reihakuro/DoAn2/schematic/power-source-board.png

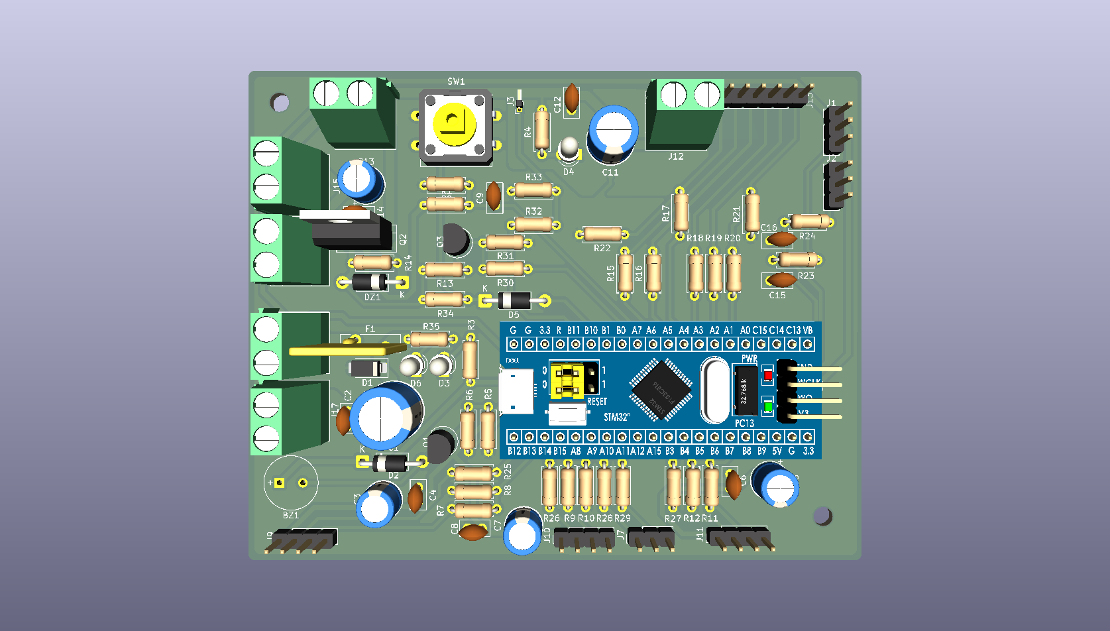
schematic/power-source-board.png
