reihakuro/DoAn2/Xe tự hành vận chuyển linh kiện.docx

Chống Định Khang - 23161277

Phạm Trung Kiên - 23161283

XE TỰ HÀNH VẬN CHUYỂN LINH KIỆN

1. Đặt vấn đề

Trong các môi trường làm việc kỹ thuật như phòng thí nghiệm điện tử, xưởng lắp ráp thiết bị và văn phòng nghiên cứu, nhu cầu luân chuyển các khay linh kiện, bo mạch mẫu, tài liệu và dụng cụ đo đạc giữa các bàn làm việc diễn ra liên tục. Việc di chuyển thủ công các vật phẩm nhỏ này làm gián đoạn thời gian tập trung chuyên môn của kỹ sư, đồng thời giảm hiệu suất chung của dây chuyền thử nghiệm.

Đề tài “Xe tự hành vận chuyển linh kiện” được triển khai nhằm xây dựng một mô hình xe tự hành cỡ nhỏ phục vụ giao nhận vật tư kỹ thuật tự động. Hệ thống không phụ thuộc vào các đường dẫn cố định bằng cách sử dụng thị giác máy tính nhận diện mốc tại các trạm đích kết hợp camera cố định với xoay thân xe, cụm cảm biến khoảng cách đa hướng và cảm biến đo tốc độ bánh xe. Toàn bộ hệ thống vận hành theo kiến trúc điều khiển phân tầng giữa máy tính nhúng và vi điều khiển thời gian thực để giám sát và điều khiển từ xa thông qua Web.

2. Mục tiêu đề tài

Mục tiêu chính của đề tài là thiết kế và chế tạo mô hình xe tự hành vận chuyển nội bộ hoạt động ổn định, đáp ứng yêu cầu an toàn không phụ thuộc vào vạch kẻ đường cố định. Các mục tiêu cụ thể bao gồm:

- Tự hành điều hướng theo mốc: Nhận diện mã hình học dán tại các trạm làm việc thông qua camera phía trước, tính toán sai số góc lệch để tự động bám quỹ đạo và di chuyển chính xác đến trạm đích trong không gian mở.
- Quét tìm trạm bằng xoay thân xe: Camera được gắn cố định cứng vững trên thân xe; hệ thống điều khiển thân xe xoay từng góc để tìm kiếm trạm.
- Kiểm soát an toàn và phản xạ: Sử dụng cụm cảm biến khoảng cách đa hướng phía trước quét theo phân chia thời gian để dừng khẩn cấp khi gặp người đi cắt ngang hoặc tránh chướng ngại vật tĩnh, kết hợp nút dừng khẩn cấp ngắt trực tiếp nguồn động cơ.
- Tối ưu hóa kiến trúc điều khiển phân tầng: Xử lý ảnh và vận hành máy chủ điều phối web cho máy tính nhúng, đo đạc cảm biến thời gian thực điều khiển động cơ và ngắt an toàn cho vi điều khiển.
- Thử nghiệm hoạt động thực tế trong môi trường test: Kiểm tra khả năng nhận diện mốc, tự động di chuyển đến đúng vị trí trạm chỉ định và phản xạ dừng an toàn khi gặp chướng ngại vật.

3. Thiết kế hệ thống

3.1. Yêu cầu người dùng

Hệ thống được thiết kế hướng tới hỗ trợ công tác luân chuyển vật tư trong phòng thí nghiệm, đáp ứng các yêu cầu thực tế sau:

- Tiếp nhận lệnh điều phối từ xa: Người vận hành tại các bàn đo đạc có thể sử dụng điện thoại hay máy tính truy cập trang web điều phối để phát lệnh yêu cầu xe vận chuyển linh kiện giữa các trạm mà không cần thao tác trực tiếp trên thân xe.
- Tự động tìm kiếm và dừng tại trạm chính xác: Sau khi nhận lệnh, xe tự kích hoạt cụm camera quét tìm trạm yêu cầu, bám theo mục tiêu và dừng đỗ ổn định trước bàn làm việc để người dùng giao nhận khay linh kiện.
- Đảm bảo an toàn tuyệt đối khi di chuyển: Xe liên tục kiểm tra chướng ngại vật phía trước, tự động dừng và phát còi cảnh báo khi có người qua lại, trang bị nút dừng khẩn cấp trên nóc xe để ngắt nguồn động cơ ngay lập tức khi cần thiết.
- Giám sát hình ảnh: Người dùng có thể theo dõi góc nhìn phía trước của xe qua luồng video trực tiếp trên giao diện web, quan sát trạng thái nhiệm vụ và số đo khoảng cách an toàn thời gian thực.
- Khởi động nhanh và hiển thị thông số tại chỗ: Xe tự động kết nối mạng không dây và hiển thị địa chỉ truy cập trên màn hình nhỏ tại thân xe, hỗ trợ kết nối vận hành nhanh chóng ngay sau khi bật nguồn.
- Nguồn điện vận hành độc lập và ổn định: Tách biệt nguồn cấp cho bộ xử lý trung tâm và nguồn cấp cho mạch công suất động cơ, đảm bảo hệ thống không bị khởi động lại do hiện tượng sụt áp khi xe tăng tải hoặc đảo chiều.

3.2. Đặc tả kỹ thuật

3.2.1. Chức năng kỹ thuật

Hệ thống đảm nhiệm các chức năng kỹ thuật cụ thể sau:

- Chức năng nhận diện: Máy tính nhúng thu nhận hình ảnh từ camera, nhận diện mã định danh tại các trạm xác định khoảng cách và góc lệch của xe so với mục tiêu để điều chỉnh hướng lái chính xác.
- Chức năng quét tìm kiếm: Điều khiển thân xe xoay từng góc để camera cố định quét toàn cảnh tìm kiếm mốc trạm đích theo yêu cầu.
- Chức năng phát hiện vật cản: Vi điều khiển liên tục đọc cụm 3 cảm biến khoảng cách phía trước theo chu kỳ phân chia thời gian chống nhiễu chéo và đọc xung cảm biến đĩa quang để kiểm soát chuyển động.
- Chức năng điều khiển động cơ và phản xạ an toàn: Vi điều khiển tự động điều chỉnh tốc độ và chiều quay động cơ để lái xe bám theo mục tiêu, dừng khẩn cấp khi phát hiện chướng ngại vật.
- Chức năng giám sát và điều phối qua web: Triển khai máy chủ web trên máy tính nhúng để truyền phát luồng video camera, tiếp nhận yêu cầu giao nhận và phản hồi trạng thái vận hành của xe.
- Chức năng truyền dữ liệu: Thiết lập kênh giao tiếp nối tiếp hai chiều giữa máy tính nhúng và vi điều khiển, đảm bảo truyền nhận liên tục các lệnh điều hướng, dữ liệu đo đạc từ cảm biến và trạng thái hoạt động của hệ thống.

3.2.2. Thông số kỹ thuật của hệ thống

- Hệ thống sử dụng hai nhánh nguồn pin sạc độc lập: Nhánh 3S hạ áp cấp cho máy tính nhúng và vi điều khiển thời gian thực; Nhánh 2S cấp cho mạch công suất động cơ, tích hợp mạch đo điện áp pin cảnh báo và chống sụt áp.
- Camera góc rộng gắn cố định trên thân xe kết hợp xoay thân xe hỗ trợ quét xung quanh.
- Cụm cảm biến khoảng cách gồm 3 cảm biến độc lập, tổng góc quét bao quát đạt trên 120 độ phía trước xe, dải đo hiệu quả từ 2cm đến 200cm với sai số dưới ±1cm.
- Cụm cảm biến khoảng cách được phân chia thời gian quét 25ms mỗi cảm biến, giảm hiện tượng dội chéo sóng âm.
- Thời gian phản xạ dừng xe khi phát hiện vật cản nguy hiểm của vi điều khiển thời gian thực dưới 20 ms.
- Tốc độ truyền giữa hai bộ xử lý đạt 115200 baud với chu kỳ cập nhật dữ liệu dưới 50 ms.
- Tốc độ truyền hình ảnh qua mạng không dây đạt 20 - 30 khung hình/giây với độ phân giải tiêu chuẩn.

3.3. Kiến trúc hệ thống

3.3.1. Các khối chức năng

Hệ thống được cấu thành từ 5 khối chức năng chính theo cấu trúc phân tầng:

- Khối thu thập dữ liệu: Gồm camera gắn cố định phía trước thân xe, cụm cảm biến khoảng cách đa hướng quét theo cơ chế phân chia thời gian và cảm biến đĩa quang đo tốc độ bánh xe.
- Khối xử lý trung tâm: Gồm máy tính nhúng phụ trách xử lý thị giác, quản lý máy trạng thái hữu hạn và vận hành máy chủ web điều phối, kết hợp vi điều khiển thời gian thực phụ trách đọc cảm biến và điều khiển động cơ.
- Khối chấp hành: Gồm mạch điều khiển công suất cầu H, các động cơ dẫn động bánh xe, còi báo động âm thanh và nút dừng khẩn cấp.
- Khối hiển thị: Màn hình đồ họa nhỏ gắn trên thân xe hiển thị địa chỉ mạng và thông số trạng thái kết nối tại chỗ.
- Khối giao tiếp: Truyền thông không dây kết nối người giám sát với máy chủ điều phối nội bộ trên xe.

3.3.2. Nguyên lý hoạt động

Xe vận hành tự động theo chu trình 5 trạng thái chính:

Trạng thái 1 - Chờ lệnh: Sau khi bật nguồn, màn hình trên thân xe hiển thị địa chỉ IP mạng nội bộ. Xe đứng yên tại trạm xuất phát và chờ người dùng chọn điểm đến trên giao diện Web.

Trạng thái 2 - Quét tìm mốc: Khi nhận lệnh, xe thực hiện xoay tại chỗ từng bước nhỏ (15 - 20 độ) rồi dừng chụp ảnh kiểm tra. Ngay khi camera bắt được đúng mã mốc của trạm đích, xe dừng xoay và chuyển sang căn chỉnh hướng.

Trạng thái 3 - Di chuyển bám mốc: Khi đã khóa được mốc, máy tính nhúng liên tục tính sai số lệch ngang giữa tâm mốc và trục giữa camera để điều khiển lái bằng thuật toán PD: nếu mốc lệch sang trái thì giảm tốc bánh trái - tăng tốc bánh phải để bẻ lái sang trái, nếu mốc lệch sang phải thì điều khiển ngược lại, khi mốc nằm ngay chính giữa thì hai bên bánh chạy cùng tốc độ để xe tiến thẳng về trạm.

Trạng thái 4 - Xử lý vật cản: Cảm biến liên tục đo khoảng cách phía trước trong lúc xe chạy:

- Gặp người đi cắt ngang: Xe dừng ngay lập tức, phát còi cảnh báo, khi người đi qua và đường thoáng trở lại, xe tiếp tục bám mốc chạy tiếp.
- Gặp đồ vật chắn đường cố định: Xe điều chỉnh nhẹ sang bên thoáng nếu camera vẫn còn nhìn thấy mốc, nếu vật cản che khuất hoàn toàn mốc thì xe dừng hẳn để chờ xử lý.

Trạng thái 5 - Dừng tại trạm: Khi xe tiến sát trạm đích, xe dừng hẳn, còi kêu bíp báo hiệu để người dùng lấy khay linh kiện, sau đó xe quay về trạng thái chờ lệnh tiếp theo.

3.4. Sơ đồ khối hệ thống

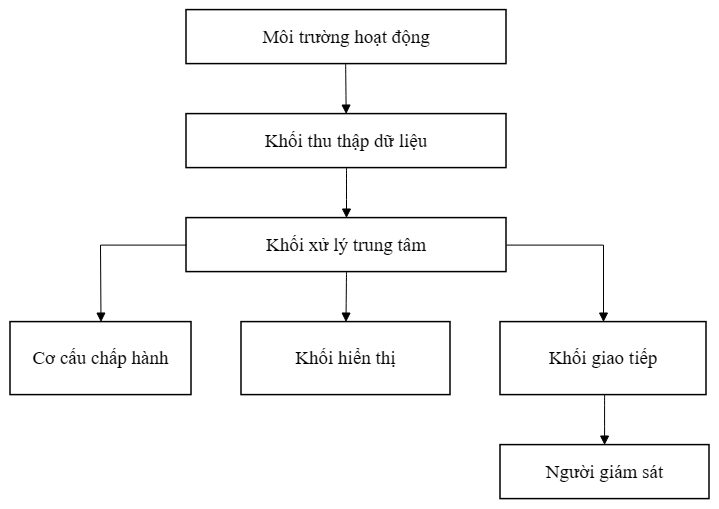
[picture p4: figure]
