reihakuro/DoAn2/docs/schematic.png

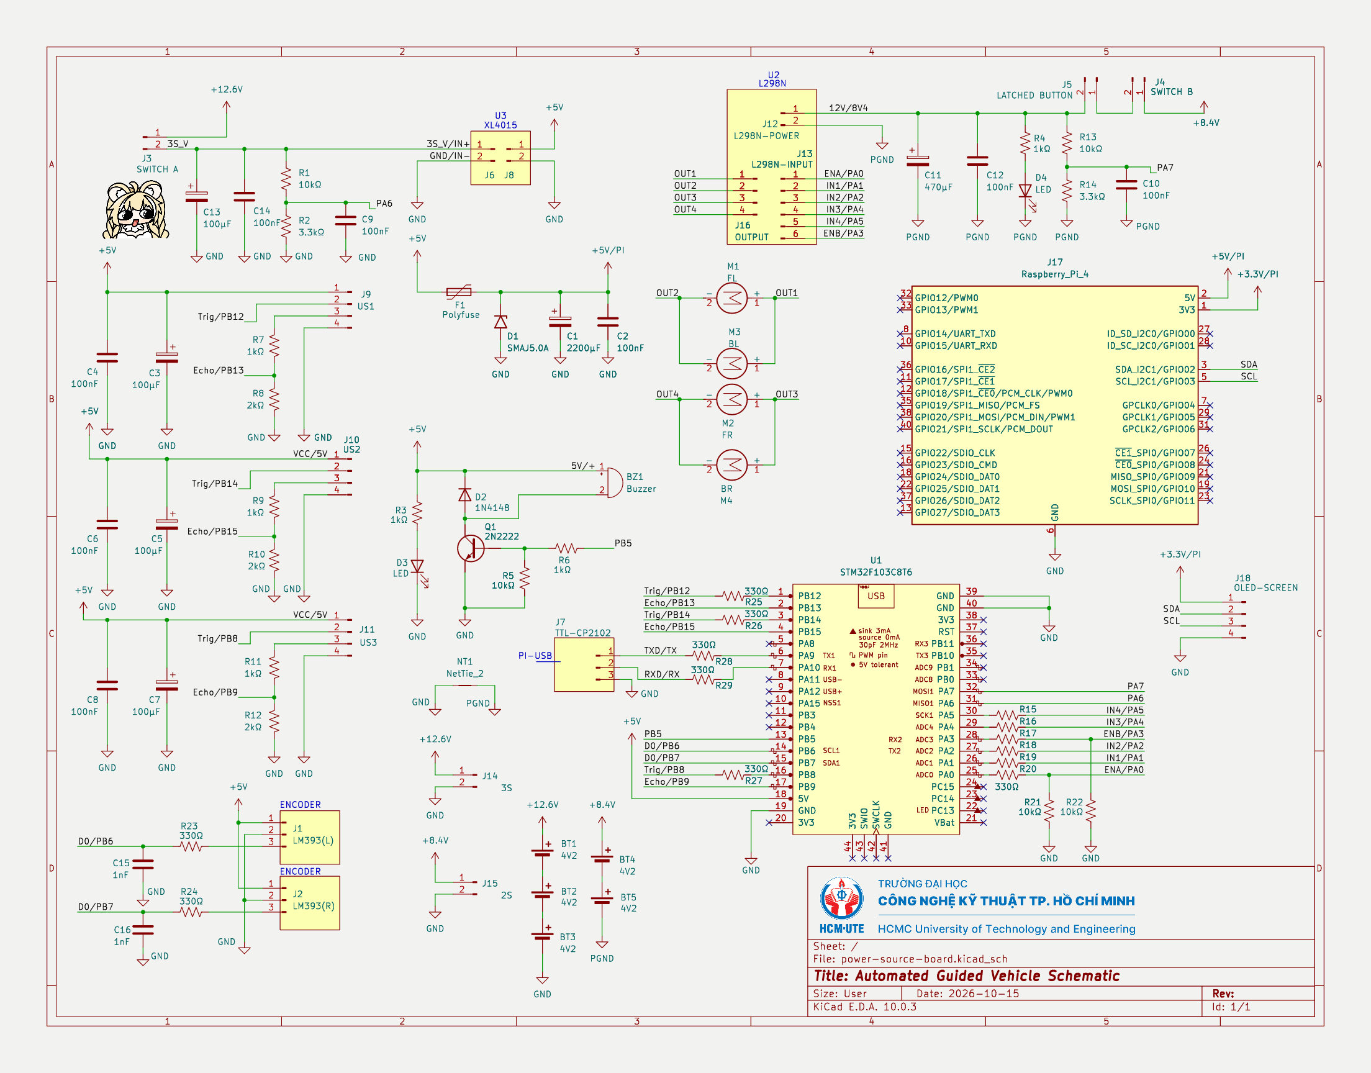
docs/schematic.png
