reihakuro/DoAn2/schematic/RUEF400.step

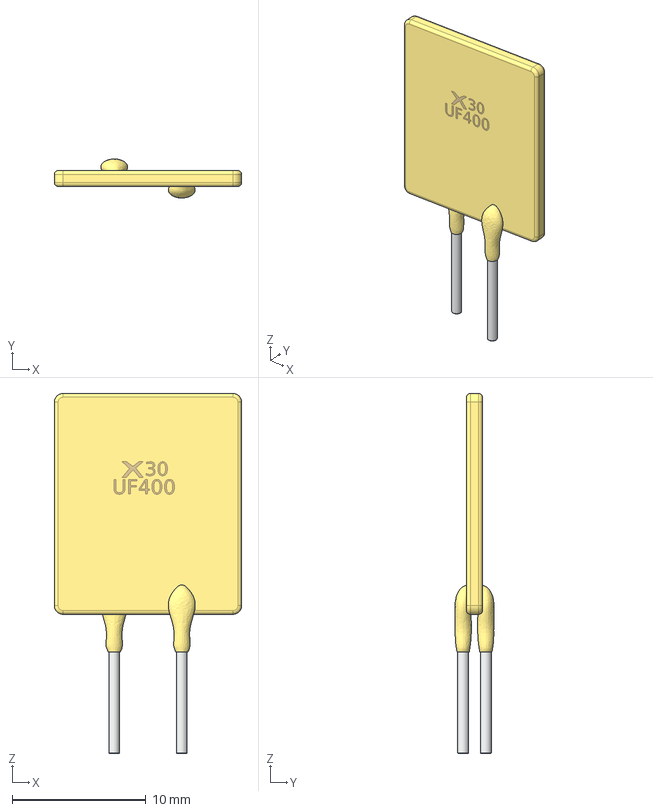
[picture p6: CAD file, 2026-10-25]
schematic/RUEF400.step
14.0 x 2.93 x 26.9 mm
Yellow epoxy package
Lead 1
Lead 2
