reihakuro/DoAn2/schematic/B3F-4055--3DModel-STEP-418109.STEP

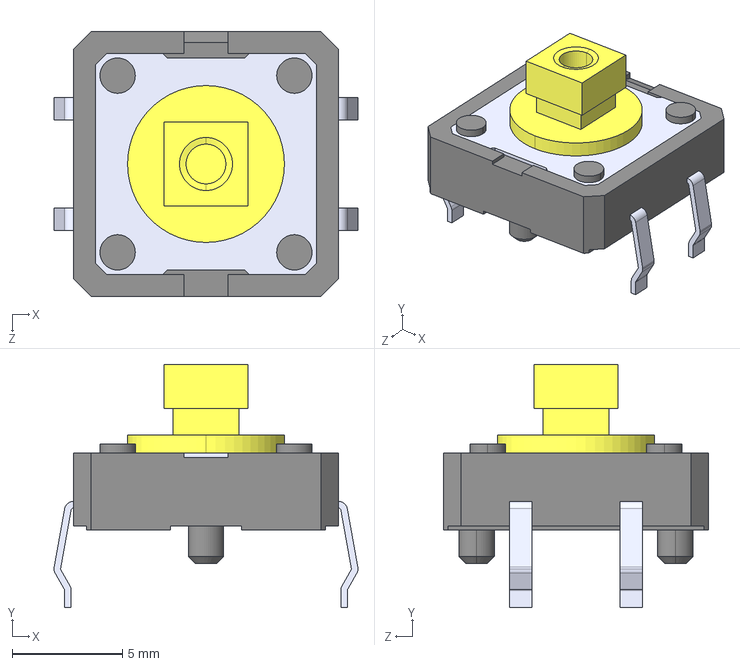
[picture p7: CAD file, 2026-10-25]
schematic/B3F-4055--3DModel-STEP-418109.STEP
13.8 x 11.0 x 12.0 mm
