reihakuro/DoAn2/schematic/power-source-board-F_Cu.pdf

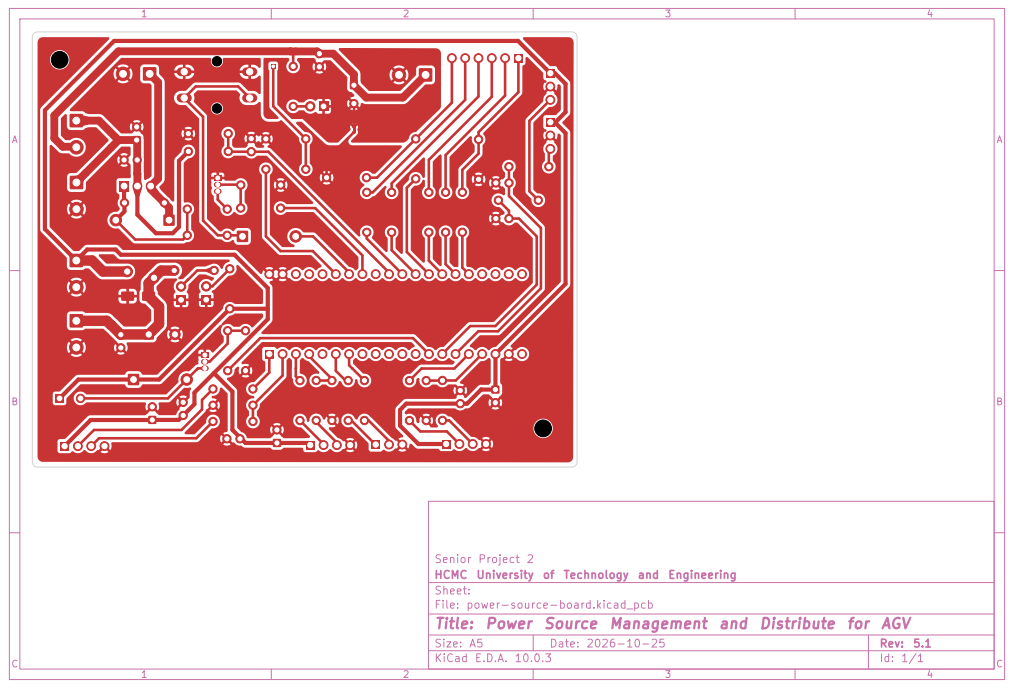
[picture p8: page 1]

Senior Project 2
HCMC University of Technology and Engineering
Sheet:
File: power-source-board.kicad_pcb
Title: Power Source Management and Distribute for AGV

Size: A5 | Rev: 5.1 | C Date: 2026-10-25
KiCad E.D.A. 10.0.3 | Id: 1/1
