reihakuro/DoAn2/schematic/power-source-board.pdf

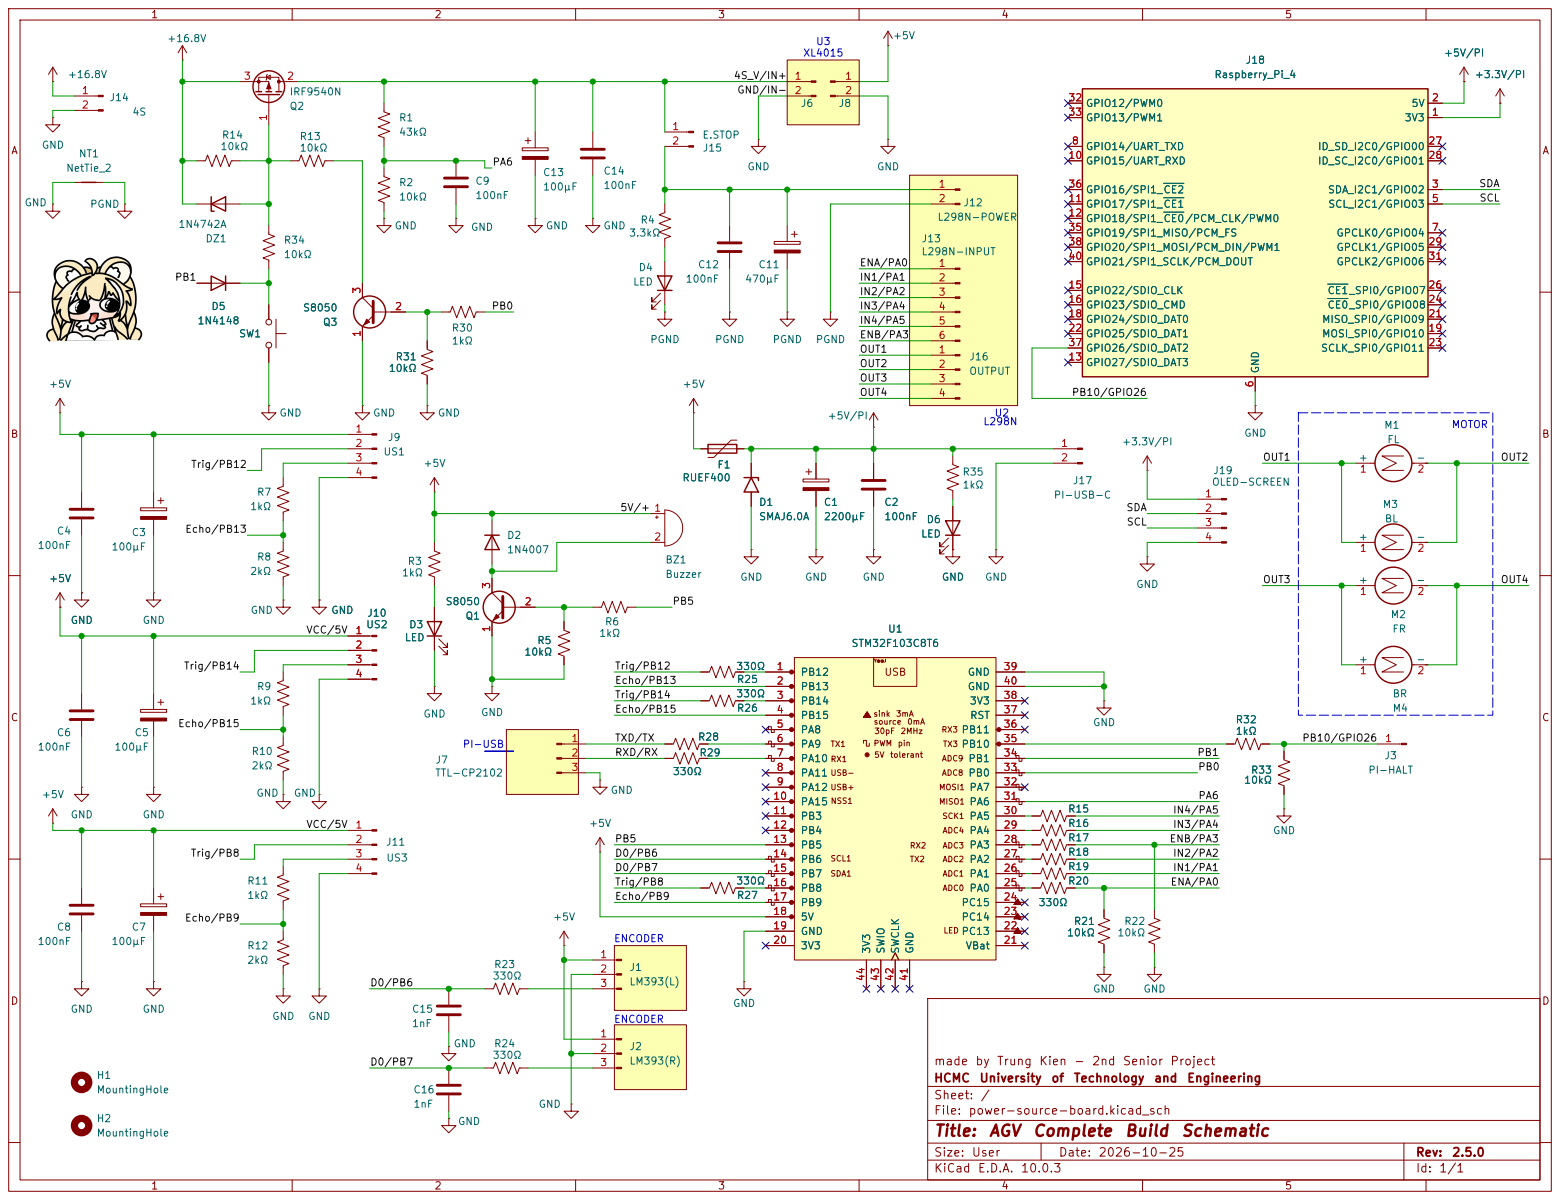
[picture p9: page 1]

made by Trung Kien - 2nd Senior Project GND

HCMC University of Technology and Engineering
Sheet: /
File: power-source-board.kicad_sch
Title: AGV Complete Build Schematic

Size: User | Rev: 2.5.0
KiCad E.D.A. 10.0.3 | Id: 1/1
