reihakuro/DoAn2/docs/schematic.pdf

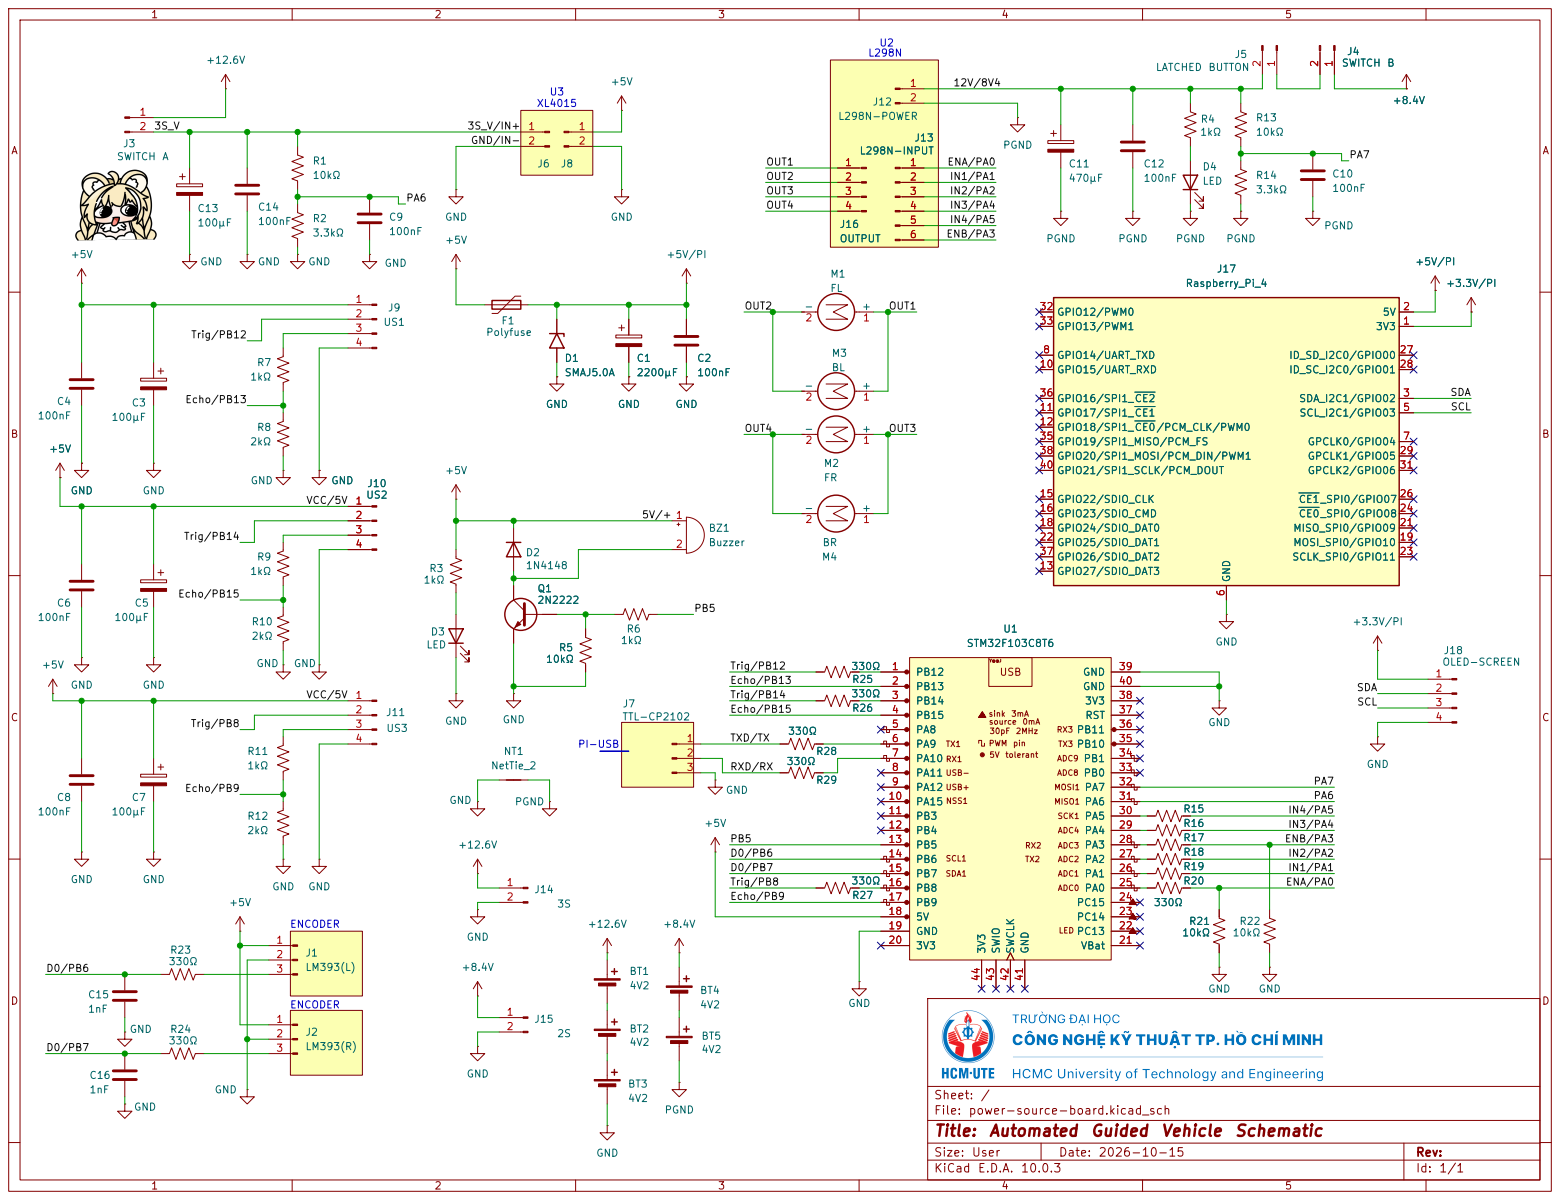
[picture p10: page 1]

Sheet: /
File: power-source-board.kicad_sch
Title: Automated Guided Vehicle Schematic

Size: User | Rev:
KiCad E.D.A. 10.0.3 | Id: 1/1
