reihakuro/DoAn2/schematic/power-source-board.kicad_pcb

## KiCad design schematic/power-source-board.kicad_pcb (2026-10-25)

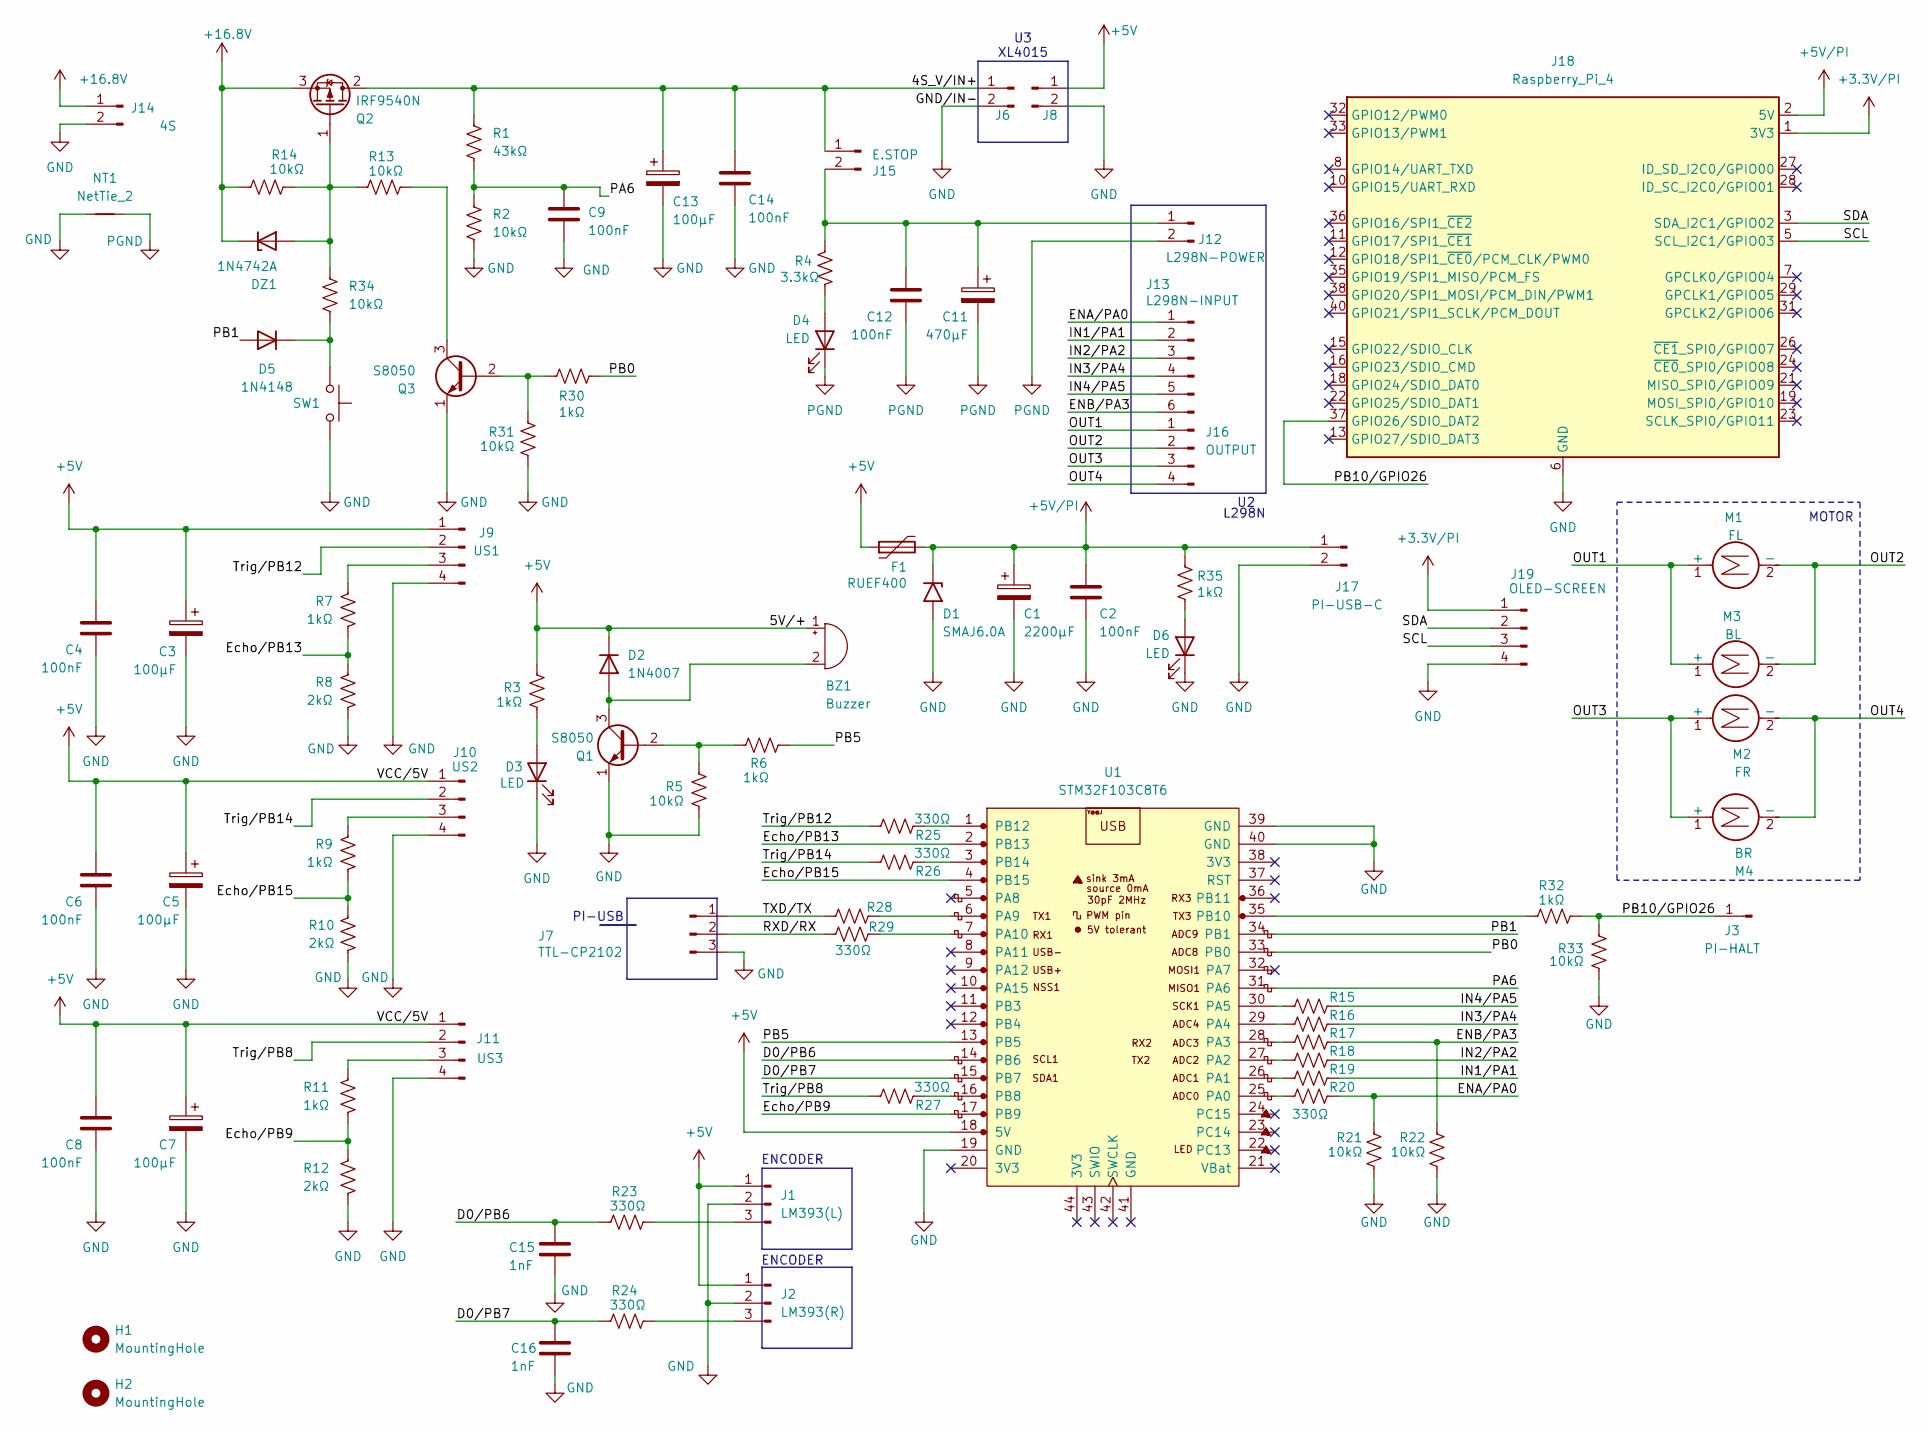
[picture p11: schematic power-source-board.kicad_sch, AGV Complete Build Schematic]

Parts:
BZ1: Buzzer; MagneticBuzzer_PUI_AT-0927-TT-6-R
C1: 2200µF; CP_Radial_D10.0mm_P5.00mm
C2, C4, C6, C8, C9, C12, C14: 100nF; C_Disc_D5.0mm_W2.5mm_P2.50mm
C3, C5, C7, C13: 100µF; CP_Radial_D6.3mm_P2.50mm
C11: 470µF; CP_Radial_D8.0mm_P3.50mm
C15, C16: 1nF; C_Disc_D5.0mm_W2.5mm_P2.50mm
D1: SMAJ6.0A; D_SMA
D2: 1N4007; D_DO-41_SOD81_P10.16mm_Horizontal
D3, D4, D6: LED; LED_D3.0mm_Clear
D5: 1N4148; D_DO-41_SOD81_P10.16mm_Horizontal
DZ1: 1N4742A; D_DO-41_SOD81_P10.16mm_Horizontal
F1: RUEF400; Fuse_Bourns_MF-RHT400
H1, H2: MountingHole; MountingHole_3.2mm_M3
J1: LM393(L); PinHeader_1x03_P2.54mm_Vertical
J2: LM393(R); PinHeader_1x03_P2.54mm_Vertical
J3: PI-HALT; PinHeader_1x01_P1.00mm_Horizontal
J6, J8: Conn_01x02_Pin; TerminalBlock_Phoenix_MKDS-1,5-2-5.08_1x02_P5.08mm_Horizont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
J7: TTL-CP2102; PinHeader_1x03_P2.54mm_Vertical
J9: US1; PinHeader_1x04_P2.54mm_Vertical
J10: US2; PinHeader_1x04_P2.54mm_Vertical
J11: US3; PinHeader_1x04_P2.54mm_Vertical
J12: L298N-POWER; TerminalBlock_Phoenix_MKDS-1,5-2-5.08_1x02_P5.08mm_Horizont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
J13: L298N-INPUT; PinHeader_1x06_P2.54mm_Vertical
J14: 4S; TerminalBlock_Phoenix_MKDS-1,5-2-5.08_1x02_P5.08mm_Horizont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
J15: E.STOP; TerminalBlock_Phoenix_MKDS-1,5-2-5.08_1x02_P5.08mm_Horizont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
J16: OUTPUT
J17: PI-USB-C; TerminalBlock_Phoenix_MKDS-1,5-2-5.08_1x02_P5.08mm_Horizont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
J18: Raspberry_Pi_4
J19: OLED-SCREEN
M1: FL
M2: FR
M3: BL
M4: BR
NT1: NetTie_2; NetTie-2_SMD_Pad0.5mm
Q1, Q3: S8050; TO-92_Inline
Q2: IRF9540N; TO-220-3_Vertical
R1: 43kΩ; R_Axial_DIN0207_L6.3mm_D2.5mm_P7.62mm_Horizontal
R2, R5, R13, R14, R21, R22, R31, R33, R34: 10kΩ; R_Axial_DIN0207_L6.3mm_D2.5mm_P7.62mm_Horizontal
R3, R6, R7, R9, R11, R30, R32, R35: 1kΩ; R_Axial_DIN0207_L6.3mm_D2.5mm_P7.62mm_Horizontal
R4: 3.3kΩ; R_Axial_DIN0207_L6.3mm_D2.5mm_P7.62mm_Horizontal
R8, R10, R12: 2kΩ; R_Axial_DIN0207_L6.3mm_D2.5mm_P7.62mm_Horizontal
R15, R16, R17, R18, R19, R20, R23, R24, R25, R26, R27, R28, R29: 330Ω; R_Axial_DIN0207_L6.3mm_D2.5mm_P7.62mm_Horizontal
SW1: A; SW_SPST_Omron_B3F-40xx
U1: STM32F103C8T6; YAAJ_BluePill_2

Connections:
+5V: BZ1.1 (+), C3.1, C4.1, C5.1, C6.1, C7.1, C8.1, D2.1 (K), F1.1, J1.1, J2.1, J8.1, J9.1, J10.1, J11.1, R3.1, U1.18 (5V)
+5V/PI: C1.1, C2.1, D1.1 (A1), F1.2, J17.1, J18.2 (5V), J18.4 (5V), R35.2
+16.8V: DZ1.1 (K), J14.1, Q2.3 (S), R14.1
/4S_V/IN+: C13.1, C14.1, J6.1, J15.1, Q2.2 (D), R1.1
/<NO NET>: J10.2, R26.1
/D0/PB6: C15.1, R23.2, U1.14 (PB6)
/D0/PB7: C16.1, R24.2, U1.15 (PB7)
/ENA/PA0: J13.1, R20.2, R21.2
/ENB/PA3: J13.6, R17.2, R22.2
/Echo/PB9: R11.2, R12.1, U1.17 (PB9)
/Echo/PB13: R7.2, R8.1, U1.2 (PB13)
/Echo/PB15: R9.2, R10.1, U1.4 (PB15)
/IN1/PA1: J13.2, R19.2
/IN2/PA2: J13.3, R18.2
/IN3/PA4: J13.4, R16.2
/IN4/PA5: J13.5, R15.2
/PA6: C9.1, R1.2, R2.1, U1.31 (PA6)
/PB0: R30.1, U1.33 (PB0)
/PB1: D5.2 (A), U1.34 (PB1)
/PB5: R6.1, U1.13 (PB5)
/PB10/GPIO26: J3.1 (Pin_1_1), J18.37 (GPIO26/SDIO_DAT2), R32.2, R33.2
/RXD/RX: J7.2, R29.1
/TXD/TX: J7.1, R28.1
/Trig/PB8: J11.2, R27.1
/Trig/PB12: J9.2, R25.1
GND: C1.2, C2.2, C3.2, C4.2, C5.2, C6.2, C7.2, C8.2, C9.2, C13.2, C14.2, C15.2, C16.2, D1.2 (A2), D3.1 (K), D6.1 (K), J1.2, J2.2, J6.2, J7.3, J8.2, J9.4, J10.4, J11.4, J14.2, J17.2, J18.6 (GND), J18.9 (GND), J18.14 (GND), J18.20 (GND), J18.25 (GND), J18.30 (GND), J18.34 (GND), J18.39 (GND), J19.4, NT1.2, Q1.1 (E), Q3.1 (E), R2.2, R5.2, R8.2, R10.2, R12.2, R21.1, R22.1, R31.2, R33.1, SW1.1, U1.19 (GND), U1.39 (GND), U1.40 (GND)
unnamed: BZ1.2 (-), D2.2 (A), Q1.3 (C)
unnamed: D3.2 (A), R3.2
unnamed: D4.2 (A), R4.1
unnamed: D5.1 (K), R34.2, SW1.2
unnamed: D6.2 (A), R35.1
unnamed: DZ1.2 (A), Q2.1 (G), R13.1, R14.2, R34.1
unnamed: J1.3, R23.1
unnamed: J2.3, R24.1
unnamed: J9.3, R7.1
unnamed: J10.3, R9.1
unnamed: J11.3, R11.1
unnamed: C11.1, C12.1, J12.1, J15.2, R4.2
unnamed: J16.1, M1.1 (+), M3.1 (+)
unnamed: J16.2, M1.2 (-), M3.2 (-)
unnamed: J16.3, M2.1 (+), M4.1 (+)
unnamed: J16.4, M2.2 (-), M4.2 (-)
unnamed: J18.1 (3V3), J18.17 (3V3), J19.1
unnamed: J18.3 (SDA_I2C1/GPIO02), J19.2
unnamed: J18.5 (SCL_I2C1/GPIO03), J19.3
unnamed: Q1.2 (B), R5.1, R6.2
unnamed: Q3.2 (B), R30.2, R31.1
unnamed: Q3.3 (C), R13.2
unnamed: R20.1, U1.25 (PA0)
unnamed: R19.1, U1.26 (PA1)
unnamed: R18.1, U1.27 (PA2)
unnamed: R17.1, U1.28 (PA3)
unnamed: R16.1, U1.29 (PA4)
unnamed: R15.1, U1.30 (PA5)
unnamed: R28.2, U1.6 (PA9)
unnamed: R29.2, U1.7 (PA10)
unnamed: R27.2, U1.16 (PB8)
unnamed: R32.1, U1.35 (PB10)
unnamed: R25.2, U1.1 (PB12)
unnamed: R26.2, U1.3 (PB14)
PGND: C11.2, C12.2, D4.1 (K), J12.2, NT1.1

Notes on the sheet:
ENCODER
MOTOR
PI-USB
L298N
XL4015

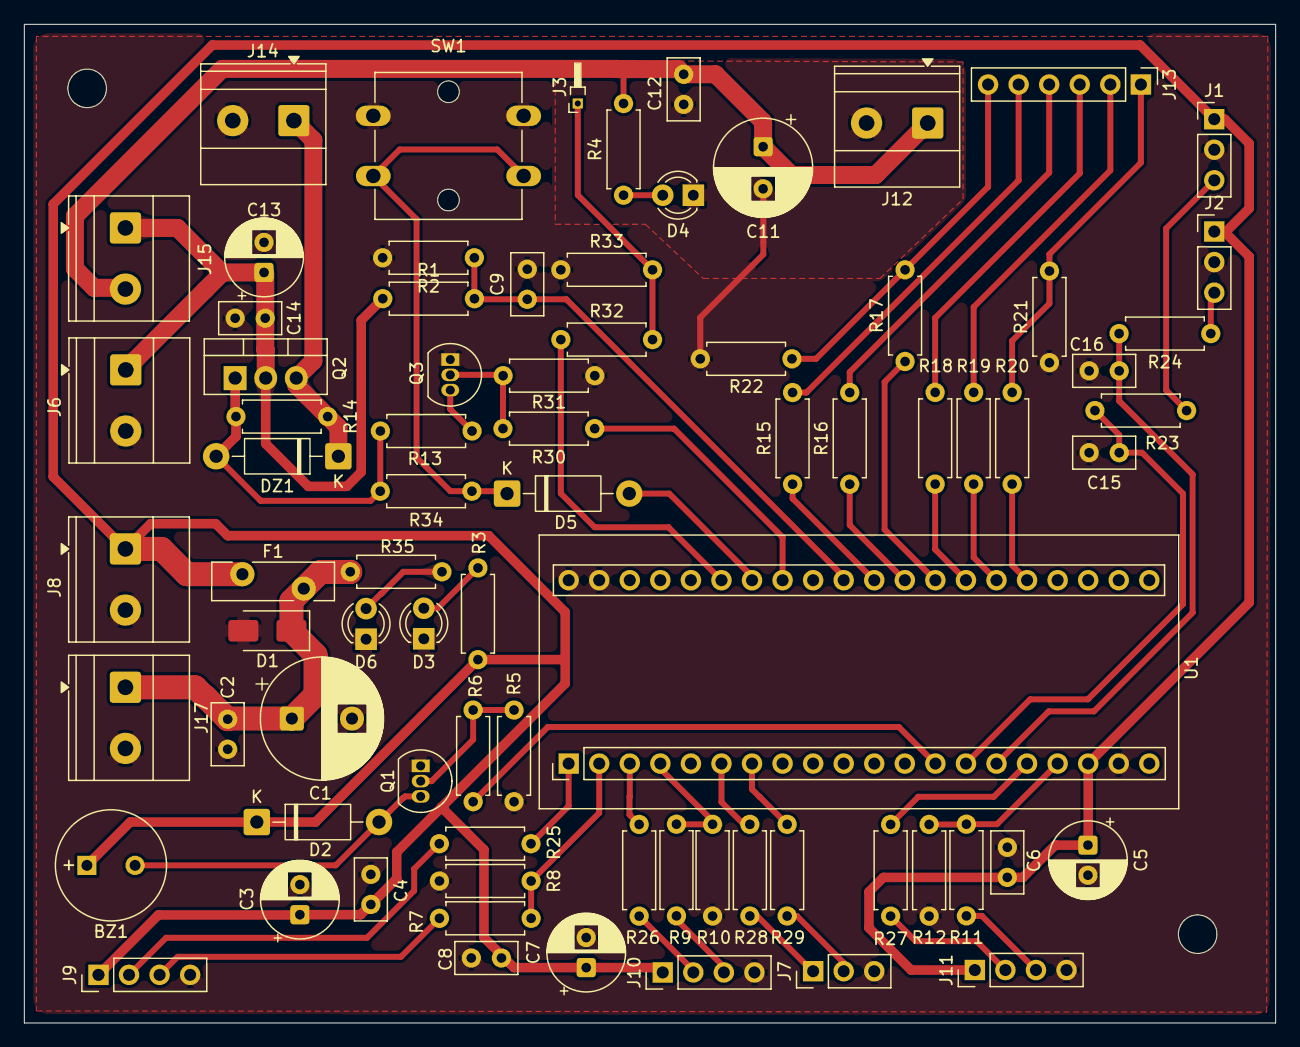
[picture p12: board power-source-board.kicad_pcb from above]

Board: 2 copper layers, 104.0 x 83.0 mm, 81 parts (0 on the bottom side), 54 nets.
