reihakuro/DoAn2/(commit log)

2026-10-15 thêm BoM mạch nguồn
2026-10-17 sua doi BoM
    [BoM.xlsx]
2026-10-25 thêm schematic project
    [B3F-4055--3DModel-STEP-418109.STEP, RUEF400.step, power-source-board.kicad_pcb, power-source-board.kicad_sch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]
2026-10-26 initial of stm32 codebase
2026-10-27 Thay đổi ghi chú
2026-10-27 Refactor header comments in adc.h and amr_app.h for clarity and consistency
2026-10-27 Enhance documentation
    - Updated header files for sonar, time, app, battery, buzzer, debug, encoder, motor, power, and sonar modules to improve clarity and detail in descriptions.
    - Added detailed explanations of hardware configurations, operational principles, and safety measures.
    - Introduced structured comments for data types and functions to enhance code readability and maintainability.
    - Improved the overall organization of the codebase to facilitate better understanding and future development.
    [amr_app.c, amr_app.h, amr_battery.c, amr_battery.h, amr_buzzer.c, amr_buzzer.h, amr_config.h, amr_debug.c]
